leo-recover/domotics/hardware/IMG-20141113-WA0000.jpg

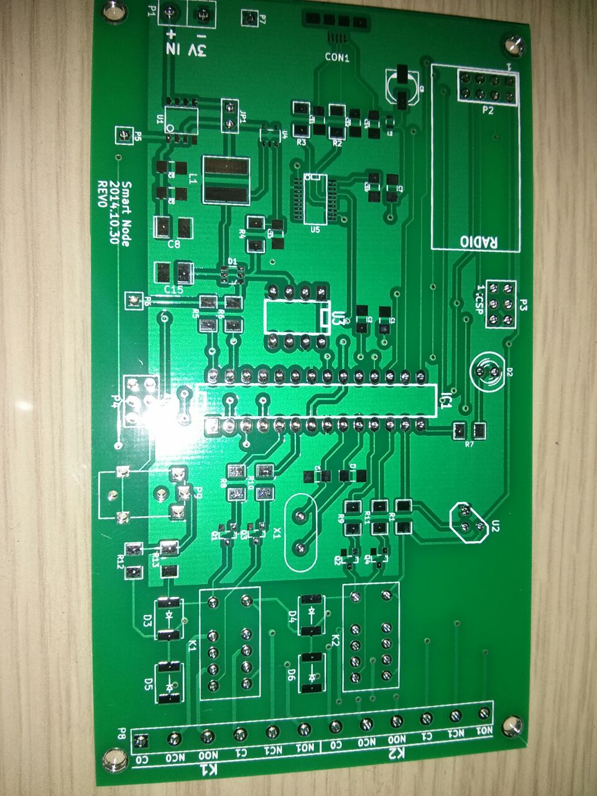
hardware/IMG-20141113-WA0000.jpg
