leo-recover/domotics/hardware/SMART_THERMOSTAT_SRF.odt

Smart Thermostat

Specifica dei Requisiti Funzionali

1. Smart Thermostat (ST) è alimentato a batteria. Non sono richiesti cavi di alimentazione;
2. L'autonomia deve essere superiore ai 6 mesi;
3. ST è comandato da una unità a microcontrollore ad 8 bit low power;
4. ST misura dati di temperatura in un intervallo che comprende almeno il range -10 °C -- +75 °C;
5. ST misura i dati di temperatura compresi nell'intervallo 0 °C -- 50 °C con un'incertezza inferiore ad 1 °C;
6. ST comunica i dati di temperatura acquisiti al gateway via radio. Non sono richiesti cavi dati;
7. ST fornisce due contatti puliti in uscita il cui stato è comandato dalla logica interna;
8. ST notifica all'utente lo stato di base di funzionamento attraverso un LED diagnostico;
9. E' possibile connettere ST ad un PC per attività basilari di debug e/o configurazione;
10. ST è configurabile;
11. In caso di mancata comunicazione con il gateway ST immagazzina i dati all'interno di una memoria Flash;
12. La memoria Flash deve essere in grado di contenere un numero almeno pari a N misurazioni;
