leo-recover/domotics/hardware/SMART_NODE_LB_BOM.xls

 | SMART NODE
 | Bill Of Materials
ref | value | footprint | Note
C1 | 100n | SMD 1206
C2 | 100n | SMD 1206
C3 | 15p | SMD 1206
C4 | 15p | SMD 1206
C5 | 1u | SMD 1206
C6 | 100n | SMD 1206
C7 | 100nF | SMD 1206
C8 | 100u | SMD POSCAP
C9 | 4.7uF | SMD
C10 | 100nF | SMD 1206
C11 | 47pF | SMD 1206
C12 | 47pF | SMD 1206
C13 | 1u | SMD 1206
C14 | 10nF | SMD 1206
C15 | 100u | SMD POSCAP
CON1 | USB-MICRO-B | SMD
D1 | ZHCS2000 | SOT-23
D2 | RED_LED | 5mm THM
D3 | 1N6479 | DO-213AB
D4 | 1N6479 | DO-213AB
D5 | 1N6479 | DO-213AB
D6 | 1N6479 | DO-213AB
IC1 | ATMEGA328P-P | DIL28
JP1 | JUMPER | THM 2.54mm
JP1 | HEADER | THM 2.54mm
K1 | RELAY_TX2-LT-3 | THM
K2 | RELAY_TX2-LT-3 | THM
L1 | 10uH | SMD
L2 | BLM18PG471SN1 | SMD 0603
P1 | BATTERY | THM 5,08mm
P2 | RADIO | THM 2.54mm
P3 | ICSP | THM 2.54mm
P4 | AUX | THM 2.54mm
P5 | BATT | THM TP
P6 | 3V3 | THM TP
P7 | GND | THM TP
P8 | RELAY | THM 5mm
Q1 | BCW33 | SOT23
Q2 | BCW33 | SOT23
Q3 | BCW33 | SOT23
Q4 | BCW33 | SOT23
R1 | 4.7K | SMD 1206
R2 | 27R | SMD 1206
R3 | 27R | SMD 1206
R4 | 10R | SMD 1206
R5 | 4.7K | SMD 1206
R6 | 4.7K | SMD 1206
R7 | 120 | SMD 1206
R8 | 750 | SMD 1206
R9 | 750 | SMD 1206
R10 | 750 | SMD 1206
R11 | 750 | SMD 1206
U1 | IRF7404 | SOIC 8
U2 | DS18B20 | TO-92
U3 | 24FC1025 | PDIP-8
U4 | SP6641B | SOT-23
U5 | FT231XS | SSOP
X1 | 16MHz | THM
EXTRA1 | SOCKET DIL28 | THM | Montare al posto di IC1
P9 | Jack Socket 4 poli 3.5mm | THM
R12 | 470K | SMD 1206
R13 | 470K | SMD 1206
