leo-recover/domotics/hardware/SMART_THERMOSTAT_BOM.ods

 | SMART THERMOSTAT
 | Bill Of Materials
ref | value | footprint | Distributor code | price (EUR) | Ordered (Y/N)
C1 | 100n | SMD 1206 | 790-0590 | 0,058
C2 | 100n | SMD 1206 | 790-0590 | 0,058
C3 | 15p | SMD 1206 | 802-9989 80-C1206C150J5G | 0,064
C4 | 15p | SMD 1206 | 802-9989 80-C1206C150J5G | 0,064
C5 | 1u | SMD 1206 | 802-9973 80-C1206C105Z3V | 0,064
C6 | 100n | SMD 1206 | 790-0590 | 0,058
C7 | 100nF | SMD 1206 | 790-0590 | 0,058
C8 | 100u | SMD POSCAP | 795-6001 | 0,792
C9 | 4.7uF | SMD | 727-1054 | 0,049
C10 | 100nF | SMD 1206 | 790-0590 | 0,058
C11 | 47pF | SMD 1206 | 464-6802 | 0,082
C12 | 47pF | SMD 1206 | 464-6802 | 0,082
C13 | 1u | SMD 1206 | 802-9973 80-C1206C105Z3V | 0,064
C14 | 10nF | SMD 1206 | 669-8410 | 0,05
C15 | 100u | SMD POSCAP | 795-6001 | 0,792
CON1 | USB-MICRO-B | SMD | 714-2353 | 0,252
D1 | ZHCS2000 | SOT-23 | 155-175 522-ZHCS2000TA | 0,598
D2 | RED_LED | 5mm THM | 646-6670 | 0,092
D3 | 1N6479 | DO-213AB | 811-6125 | 0,415
D4 | 1N6479 | DO-213AB | 811-6125 | 0,415
D5 | 1N6479 | DO-213AB | 811-6125 | 0,415
D6 | 1N6479 | DO-213AB | 811-6125 | 0,415
IC1 | ATMEGA328P-P | DIL28 | 696-2260 | 2,73
JP1 | JUMPER | THM 2.54mm | 674-2397 | 0,034
JP1 | HEADER | THM 2.54mm
K1 | RELAY_TX2-LT-3 | THM | 769-TX2-LT-3V-TH | 4,6
K2 | RELAY_TX2-LT-3 | THM | 769-TX2-LT-3V-TH | 4,6
L1 | 10uH | SMD | 851-CDRH5D28NP-100NC | 0,473
L2 | BLM18PG471SN1 | SMD 0603 | 81-BLM18PG471SN1D | 0,091
P1 | BATTERY | THM 5,08mm | 425-8720 | 0,186
P2 | RADIO | THM 2.54mm | 681-6836 | 0,792
P3 | ICSP | THM 2.54mm | 669-5348 | 0,143
P4 | AUX | THM 2.54mm | 669-5348 | 0,143
P5 | BATT | THM TP | 305-0913 | 0,197
P6 | 3V3 | THM TP | 305-0913 | 0,197
P7 | GND | THM TP | 305-0913 | 0,197
P8 | RELAY | THM 5mm | 361-7768 | 3,226
Q1 | BCW33 | SOT23 | 781-3963 | 0,027
Q2 | BCW33 | SOT23 | 781-3963 | 0,027
Q3 | BCW33 | SOT23 | 781-3963 | 0,027
Q4 | BCW33 | SOT23 | 781-3963 | 0,027
R1 | 4.7K | SMD 1206 | 223-2350 | 0,017
R2 | 27R | SMD 1206 | 223-2057 | 0,026
R3 | 27R | SMD 1206 | 223-2057 | 0,026
R4 | 10R | SMD 1206 | 740-9085 | 0,02
R5 | 4.7K | SMD 1206 | 223-2350 | 0,017
R6 | 4.7K | SMD 1206 | 223-2350 | 0,017
R7 | 120 | SMD 1206 | 679-1787 | 0,045
R8 | 750 | SMD 1206 | 679-2323 | 0,031
R9 | 750 | SMD 1206 | 679-2323 | 0,031
R10 | 750 | SMD 1206 | 679-2323 | 0,031
R11 | 750 | SMD 1206 | 679-2323 | 0,031
U1 | IRF7404 | SOIC 8 | 542-9383 | 0,92
U2 | DS18B20 | TO-92 | 540-2805 | 5,08
U3 | 24FC1025 | PDIP-8 | 687-9120 | 2,81
U4 | SP6641B | SOT-23 | 778-0788 | 1,01
U5 | FT231XS | SSOP | 757-0032 | 1,93
X1 | 16MHz | THM | 693-6970 | 0,228
EXTRA1 | SOCKET DIL28 | THM | 674-2450 | 0,152
 | Jack Socket 4 poli 3.5mm | THM | 805-1655 | 0,942
 | 470K | SMD 1206 | 71-CRCW1206J-470K-E3 | 0,066
