leo-recover/domotics/hardware/SMART_THERMOSTAT.kicad_pcb

## KiCad design hardware/SMART_THERMOSTAT.kicad_pcb (2017-12-05)

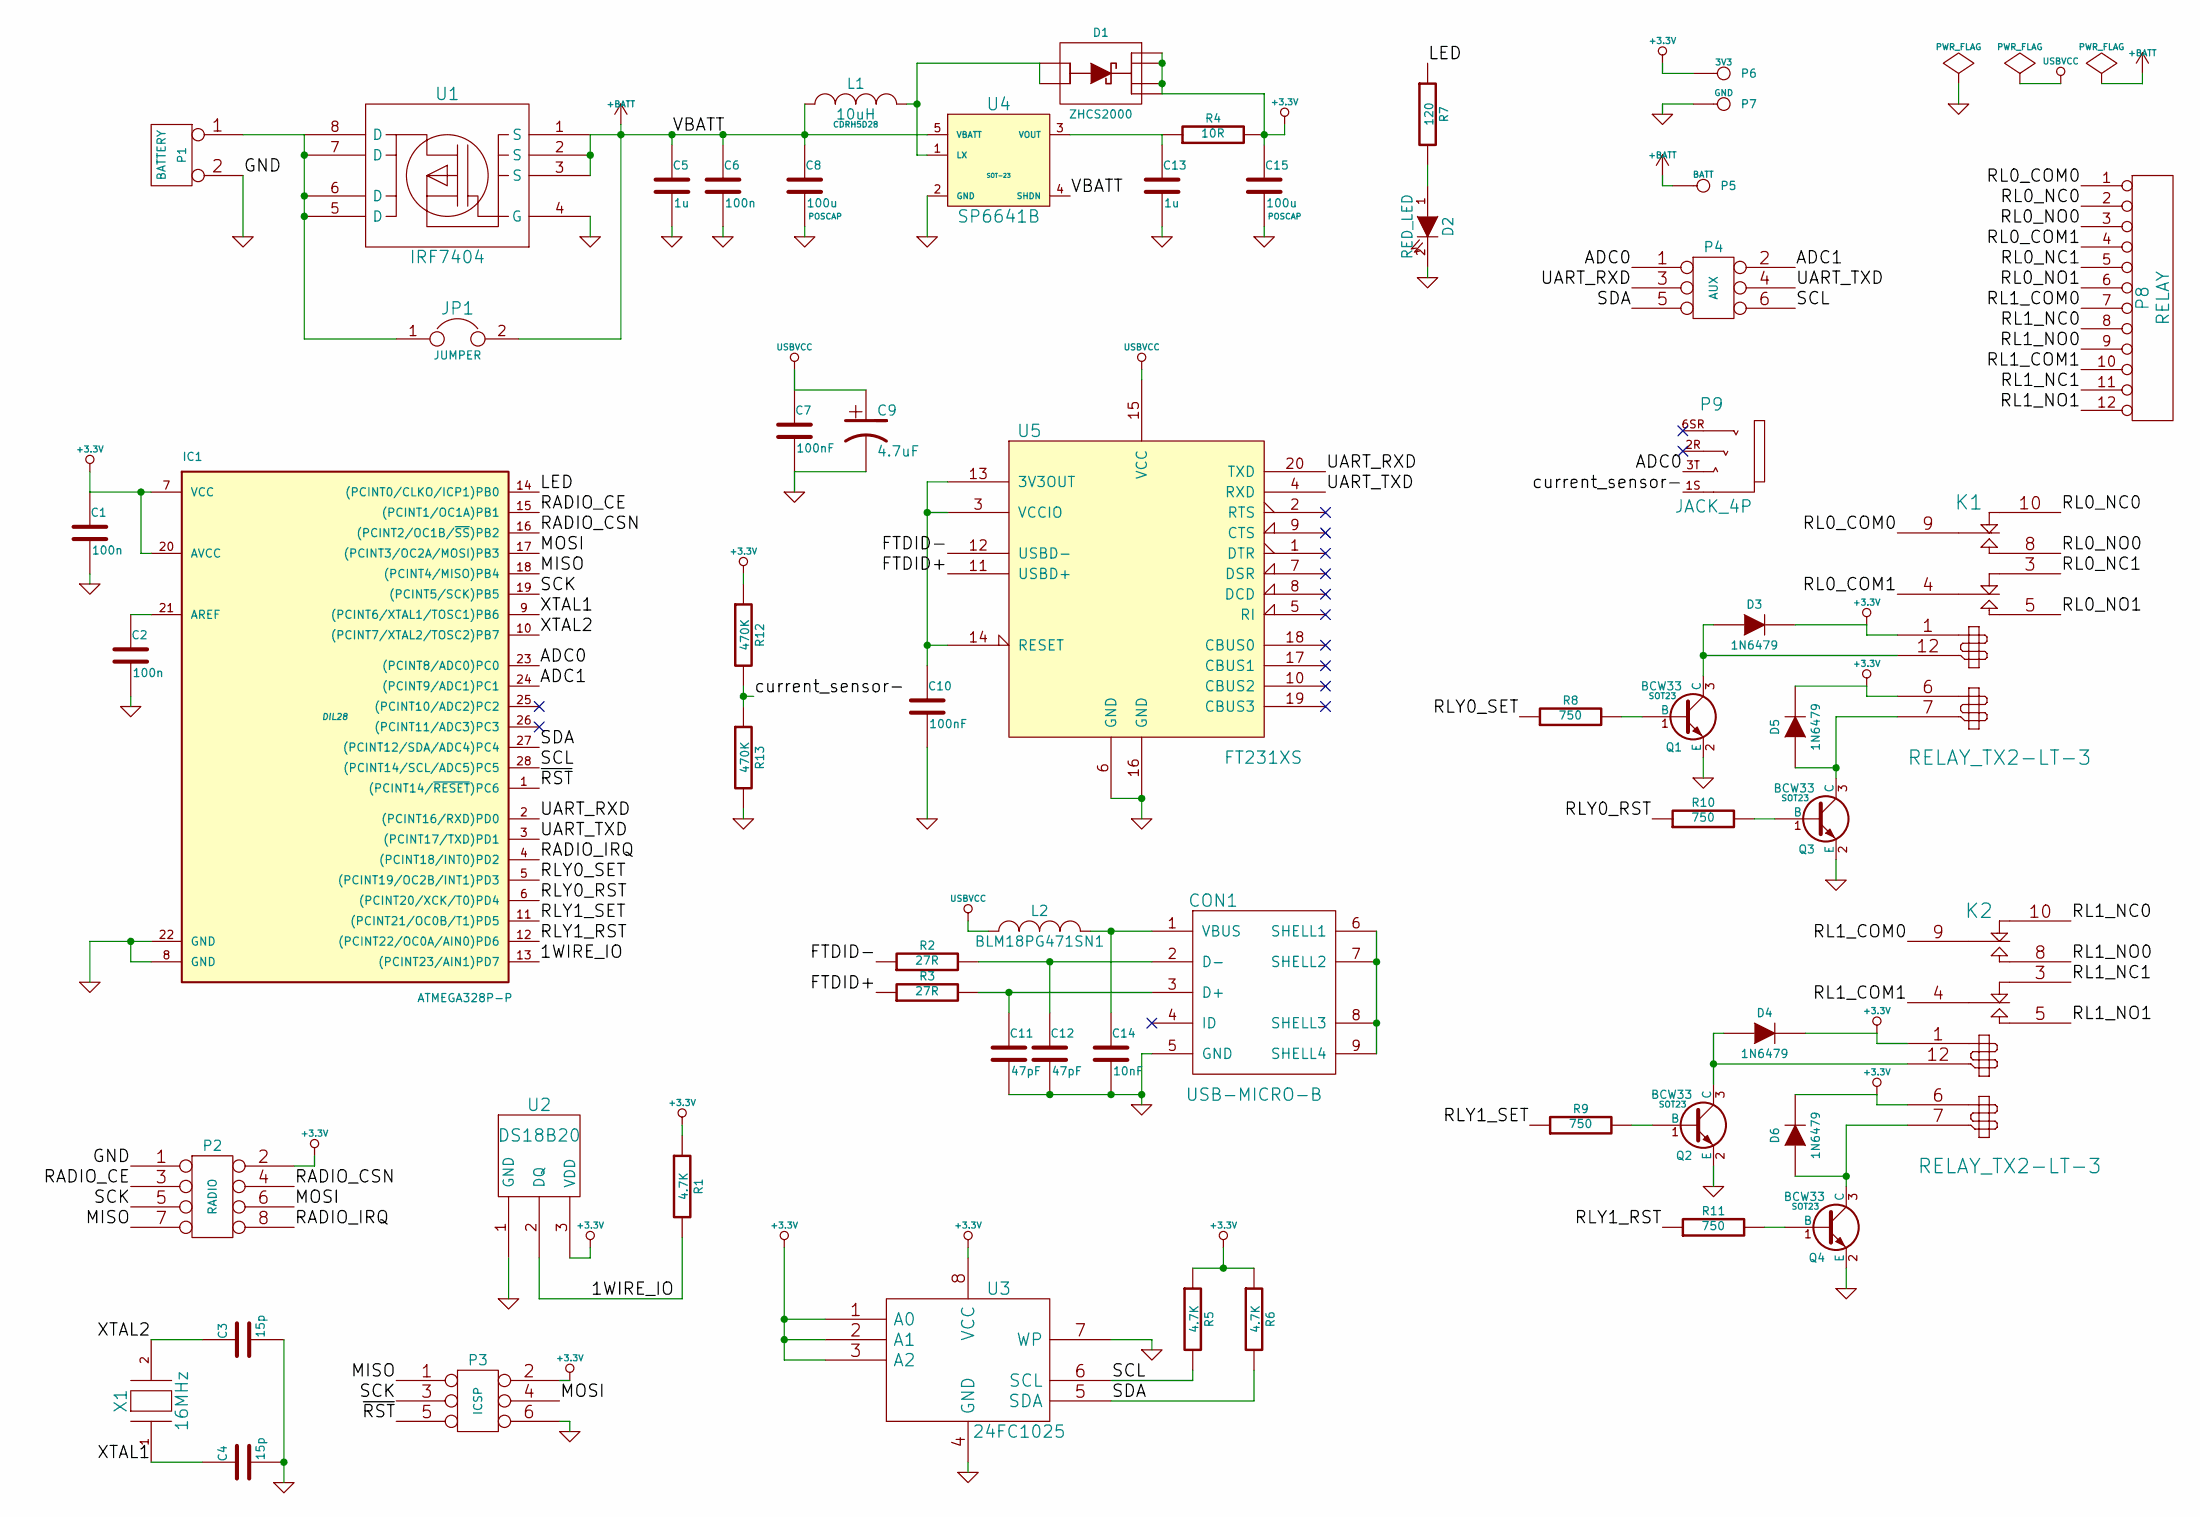
[picture p2: schematic SMART_THERMOSTAT.sch, SMART THERMOSTAT]

Parts:
C1, C2, C6: 100n
C3, C4: 15p
C5, C13: 1u
C7, C10: 100nF
C8, C15: 100u
C9: 4.7uF
C11, C12: 47pF
C14: 10nF
CON1: USB-MICRO-B
D1: ZHCS2000
D2: RED_LED
D3, D4, D5, D6: 1N6479
IC1: ATMEGA328P-P; DIL28
JP1: JUMPER
K1, K2: RELAY_TX2-LT-3
L1: 10uH
L2: BLM18PG471SN1
P1: BATTERY
P2: RADIO
P3: ICSP
P4: AUX
P5: BATT
P6: 3V3
P7: GND
P8: RELAY
P9: JACK_4P
Q1, Q2, Q3, Q4: BCW33; SOT23
R1, R5, R6: 4.7K
R2, R3: 27R
R4: 10R
R7: 120
R8, R9, R10, R11: 750
R12, R13: 470K
U1: IRF7404
U2: DS18B20
U3: 24FC1025
U4: SP6641B; SOT-23
U5: FT231XS
X1: 16MHz

Connections:
+3.3V: C1.1, C15.1, D1.1 (K), D1.2 (K), D1.5 (K), D1.6 (K), D3.2 (K), D4.2 (K), D5.2 (K), D6.2 (K), IC1.7 (VCC), IC1.20 (AVCC), K1.1, K1.6, K2.1, K2.6, P2.2, P3.2, P6.1, R1.1, R4.2, R5.1, R6.1, R12.1, U2.3 (VDD), U3.1 (A0), U3.2 (A1), U3.3 (A2), U3.8 (VCC)
+BATT: C5.1, C6.1, C8.1, JP1.2, L1.1, P5.1, U1.1 (S), U1.2 (S), U1.3 (S), U4.4 (SHDN), U4.5 (VBATT)
/1WIRE_IO: IC1.13 ((PCINT23/AIN1)PD7), R1.2, U2.2 (DQ)
/ADC0: IC1.23 ((PCINT8/ADC0)PC0), P4.1, P9.3T
/ADC1: IC1.24 ((PCINT9/ADC1)PC1), P4.2
/FTDID+: R3.1, U5.11 (USBD+)
/FTDID-: R2.1, U5.12 (USBD-)
/LED: IC1.14 ((PCINT0/CLKO/ICP1)PB0), R7.1
/MISO: IC1.18 ((PCINT4/MISO)PB4), P2.7, P3.1
/MOSI: IC1.17 ((PCINT3/OC2A/MOSI)PB3), P2.6, P3.4
/RADIO_CE: IC1.15 ((PCINT1/OC1A)PB1), P2.3
/RADIO_CSN: IC1.16 ((PCINT2/OC1B/~SS~)PB2), P2.4
/RADIO_IRQ: IC1.4 ((PCINT18/INT0)PD2), P2.8
/RL0_COM0: K1.9 (C2), P8.1
/RL0_COM1: K1.4 (C1), P8.4
/RL0_NC0: K1.10 (R2), P8.2
/RL0_NC1: K1.3 (R1), P8.5
/RL0_NO0: K1.8 (T2), P8.3
/RL0_NO1: K1.5 (T1), P8.6
/RL1_COM0: K2.9 (C2), P8.7
/RL1_COM1: K2.4 (C1), P8.10
/RL1_NC0: K2.10 (R2), P8.8
/RL1_NC1: K2.3 (R1), P8.11
/RL1_NO0: K2.8 (T2), P8.9
/RL1_NO1: K2.5 (T1), P8.12
/RLY0_RST: IC1.6 ((PCINT20/XCK/T0)PD4), R10.1
/RLY0_SET: IC1.5 ((PCINT19/OC2B/INT1)PD3), R8.1
/RLY1_RST: IC1.12 ((PCINT22/OC0A/AIN0)PD6), R11.1
/RLY1_SET: IC1.11 ((PCINT21/OC0B/T1)PD5), R9.1
/SCK: IC1.19 ((PCINT5/SCK)PB5), P2.5, P3.3
/SCL: IC1.28 ((PCINT14/SCL/ADC5)PC5), P4.6, R5.2, U3.6 (SCL)
/SDA: IC1.27 ((PCINT12/SDA/ADC4)PC4), P4.5, R6.2, U3.5 (SDA)
/UART_RXD: IC1.2 ((PCINT16/RXD)PD0), P4.3, U5.20 (TXD)
/UART_TXD: IC1.3 ((PCINT17/TXD)PD1), P4.4, U5.4 (RXD)
/XTAL1: C4.1, IC1.9 ((PCINT6/XTAL1/TOSC1)PB6), X1.1
/XTAL2: C3.1, IC1.10 ((PCINT7/XTAL2/TOSC2)PB7), X1.2
/current_sensor-: P9.1S, R12.2, R13.1
/~RST~: IC1.1 ((PCINT14/~RESET~)PC6), P3.5
GND: C1.2, C2.2, C3.2, C4.2, C5.2, C6.2, C7.2, C8.2, C9.2, C10.2, C11.2, C12.2, C13.2, C14.2, C15.2, CON1.5 (GND), D2.2 (K), IC1.8 (GND), IC1.22 (GND), P1.2 (PM), P2.1, P3.6, P7.1, Q1.2 (E), Q2.2 (E), Q3.2 (E), Q4.2 (E), R13.2, U1.4 (G), U2.1 (GND), U3.4 (GND), U3.7 (WP), U4.2 (GND), U5.6 (GND), U5.16 (GND)
unnamed: CON1.6 (SHELL1), CON1.7 (SHELL2), CON1.8 (SHELL3), CON1.9 (SHELL4)
unnamed: D6.1 (A), K2.7, Q4.3 (C)
unnamed: D3.1 (A), K1.12, Q1.3 (C)
unnamed: D4.1 (A), K2.12, Q2.3 (C)
unnamed: C14.1, CON1.1 (VBUS), L2.2
unnamed: C11.1, CON1.3 (D+), R3.2
unnamed: C12.1, CON1.2 (D-), R2.2
unnamed: C10.1, U5.3 (VCCIO), U5.13 (3V3OUT), U5.14 (RESET)
unnamed: C2.1, IC1.21 (AREF)
unnamed: JP1.1, P1.1, U1.5 (D), U1.6 (D), U1.7 (D), U1.8 (D)
unnamed: C13.1, R4.1, U4.3 (VOUT)
unnamed: D1.3 (A), D1.4 (A), L1.2, U4.1 (LX)
unnamed: Q3.1 (B), R10.2
unnamed: D5.1 (A), K1.7, Q3.3 (C)
unnamed: Q2.1 (B), R9.2
unnamed: Q4.1 (B), R11.2
unnamed: D2.1 (A), R7.2
unnamed: Q1.1 (B), R8.2
USBVCC: C7.1, C9.1, L2.1, U5.15 (VCC)

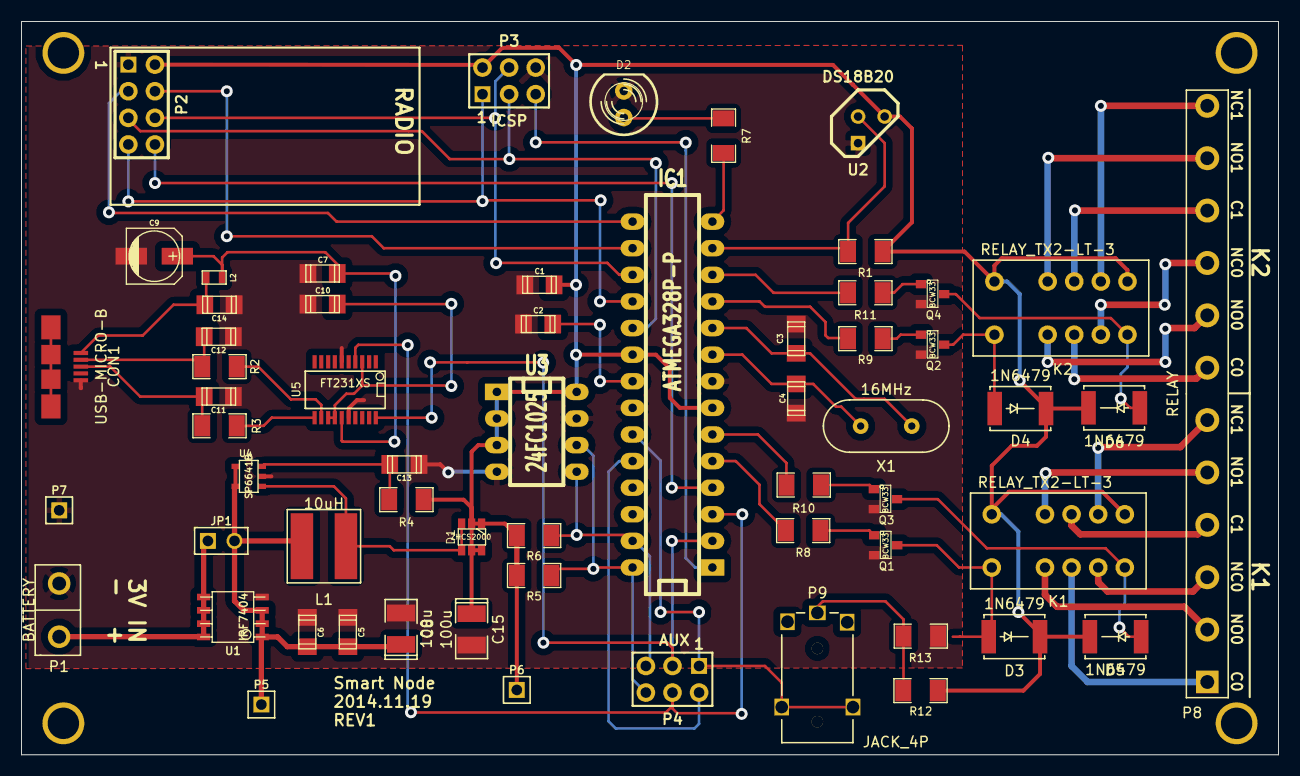
[picture p3: board SMART_THERMOSTAT.kicad_pcb from above]

Board: 2 copper layers, 120.0 x 70.0 mm, 64 parts (0 on the bottom side), 58 nets.

Other parts of the board:
HOLE_M3, HOLE_M3#2, HOLE_M3#3, HOLE_M3#4: VAL**; HOLE_M3
