leo-recover/domotics/(commit log)

2017-12-05 Added KiCAD hardware project
    [SMART_NODE_LB_BOM.xls, SMART_THERMOSTAT.csv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]
2017-12-16 First version (only experimental, not working!)
    [configuration.h]
2017-12-24 Onewire driver rework
    Avoid delays using the TC2 in CTC mode and a state machine
2017-12-26 Onewire driver rework
    Finished up implementation. Not tested.
2017-12-26 TempSensor rework
    Major rewrite of the TempSensor module. Not tested!
    [main.c]
2017-12-31 Relays module rework
    Avoid using delays but rely on a state machine
2018-01-01 Bug fixes
    Tested with simulavr for an initial debug of relays and timer modules
    [main.c]
2018-01-14 Onewire testing
    Major refactoring due to testing. Still not working.
    [main.c]
2018-01-14 Onewire & Temperature Sensor working
2018-01-27 SPI rework
2018-02-03 Minor changes to SPI
2018-02-03 Initial rework of radio driver
2018-02-04 Radio driver rework
2018-02-23 radio driver reworking
